SemuBot/SemuBot-PCB/SemuBot_WheelBase/README.md

# Wheelbase

## Components

### BLDC driver

https://www.mouser.ee/ProductDetail/Texas-Instruments/DRV8353FSRTAR?qs=hd1VzrDQEGj9xu7LrY%252BpOw%3D%3D

#### Mosfets

 DI025N06PT-AQ 
 https://www.mouser.ee/ProductDetail/Diotec-Semiconductor/DI025N06PT-AQ?qs=Y0Uzf4wQF3lNF%252Ba3rVyVBQ%3D%3D

#### Oscillator

830205889709
https://www.mouser.ee/ProductDetail/Wurth-Elektronik/830205889709?qs=hWgE7mdIu5QkPZnGbsg1Rg%3D%3D

#### Terminal block connector for 24V from battery

 TB003-500-P02BE

https://www.mouser.ee/ProductDetail/Same-Sky/TB003-500-P02BE?qs=vLWxofP3U2yAT9CFQJ%2FCaw%3D%3D

### USB C connector

https://www.mouser.ee/ProductDetail/Amphenol-FCI/10155435-00011LF?qs=vHuUswq2%252BswoQuNbiiIX%2FQ%3D%3D

### LDO Voltage Regulator
https://www.mouser.ee/ProductDetail/onsemi/NCP164CSN330T1G?qs=xZ%2FP%252Ba9zWqbi%2FAyy5UtoRw%3D%3D

### B5B-XH-A(LF)(SN) HALL Sensor connectors

https://www.mouser.ee/ProductDetail/JST-Commercial/B5B-XH-ALFSN?qs=cdbOS8ANM9ApoXpxtybURg%3D%3D

### ESD Protection

PRTR5V0U2X,215

https://www.mouser.ee/ProductDetail/Nexperia/PRTR5V0U2X215?qs=LOCUfHb8d9sDkgY4cRj8Lw%3D%3D

### Phase connectors for motors

1984620

https://www.snapeda.com/parts/1984620/Phoenix%20Contact/view-part/?ref=search&t=1984620

### Power connector XT30PW-M

https://www.tme.eu/ee/details/xt30pw-m/dc-uhendused/amass/ # 24V
https://www.tme.eu/ee/details/mr30pw-m/dc-uhendused/amass/ # motor

## Pins

* SPI pins for data
* 3x2xGPIO pin for drivers
* 3xPWM for drivers

Hc = Blue
HB = White
Ha = Yellow

Mc = Brown thick
Mb = Green thick
Ma = Orange thick

TOTAL NEEDED FROM STM32: 9(drivers)+ 3CS + SPI =13

### Encoders

* +5V
* DATA
* CLOCK
* GND
* CS
