SemuBot/SemuBot-PCB/(list of files, drawings)

Other design files:
SemuBot_WheelBase/hw_version/Wheelbase/freerouting.dsn
