SemuBot/SemuBot-PCB/SemuBot_WheelBase/Wheelbase/Wheelbase.kicad_pcb

## KiCad design SemuBot_WheelBase/Wheelbase/Wheelbase.kicad_pcb (2025-12-12)

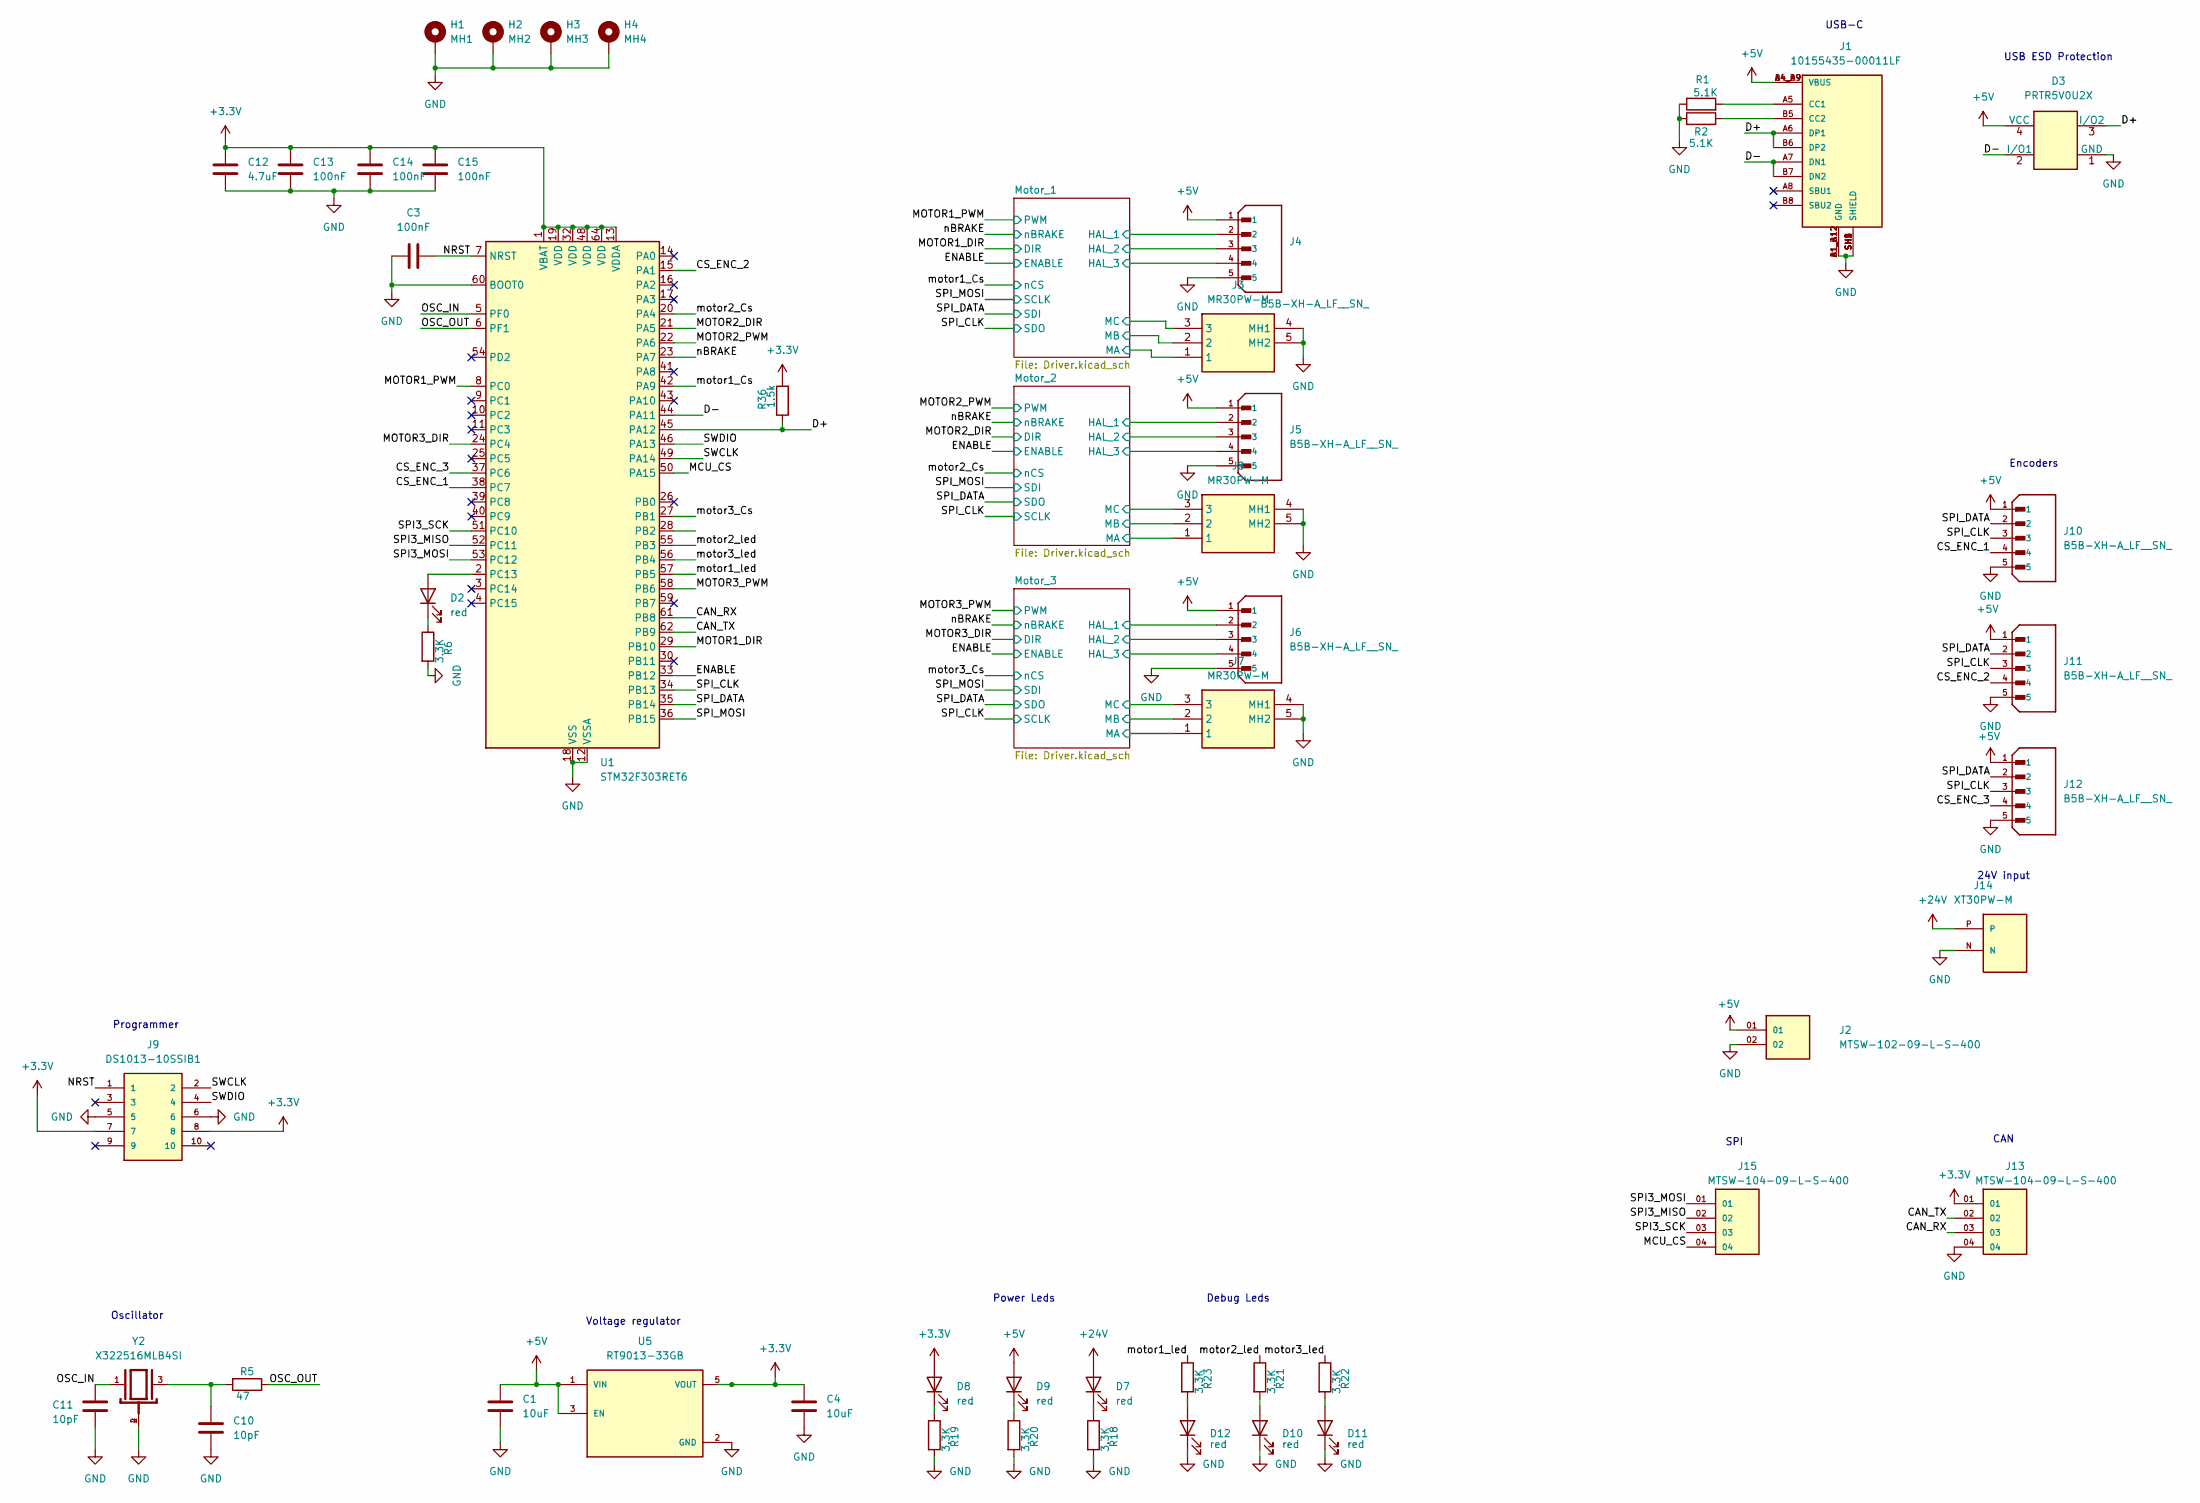
[picture p1: schematic Wheelbase.kicad_sch]

Parts:
C1, C4: 10uF; C_0805_2012Metric_Pad1.18x1.45mm_HandSolder
C3, C13, C14, C15: 100nF; C_0603_1608Metric_Pad1.08x0.95mm_HandSolder
C10, C11: 10pF; C_0603_1608Metric_Pad1.08x0.95mm_HandSolder
C12: 4.7uF; C_0603_1608Metric_Pad1.08x0.95mm_HandSolder
D2, D7, D8, D9, D10, D11, D12: red; LED_0603_1608Metric_Pad1.05x0.95mm_HandSolder
D3: PRTR5V0U2X; SOT-143
H1: MH1; MountingHole_3.2mm_M3_Pad_Via
H2: MH2; MountingHole_3.2mm_M3_Pad_Via
H3: MH3; MountingHole_3.2mm_M3_Pad_Via
H4: MH4; MountingHole_3.2mm_M3_Pad_Via
J1: 10155435-00011LF; AMPHENOL_10155435-00011LF; PARTREV C
J2: MTSW-102-09-L-S-400; SAMTEC_MTSW-102-09-L-S-400; PARTREV R
J3, J7, J8: MR30PW-M; MR30PWM; Manufacturer_Part_Number MR30PW-M
J4, J5, J6, J10, J11, J12: B5B-XH-A_LF__SN_; JST_B5B-XH-A_LF__SN_; PARTREV 7/4/21
J9: DS1013-10SSIB1; CONNFLY_DS1013-10SSIB1; PARTREV G
J13, J15: MTSW-104-09-L-S-400; SAMTEC_MTSW-104-09-L-S-400; PARTREV R
J14: XT30PW-M; AMASS_XT30PW-M; PARTREV 1.2
R1, R2: 5.1K; R_0603_1608Metric_Pad0.98x0.95mm_HandSolder
R5: 47; R_0603_1608Metric_Pad0.98x0.95mm_HandSolder
R6, R18, R19, R20, R21, R22, R23: 3.3K; R_0603_1608Metric_Pad0.98x0.95mm_HandSolder
R36: 1.5k; R_0603_1608Metric_Pad0.98x0.95mm_HandSolder
U1: STM32F303RET6; LQFP-64_10x10mm_P0.5mm
U5: RT9013-33GB; SOT94P279X129-5N; PARTREV Aprill 2011
Y2: X322516MLB4SI; OSC_X322516MLB4SI; PARTREV N/A

Connections:
+3.3V: C4.2, C12.1, C13.1, C14.1, C15.1, D8.2 (A), J9.7, J9.8, J13.01, R36.2, U1.1 (VBAT), U1.13 (VDDA), U1.19 (VDD), U1.32 (VDD), U1.48 (VDD), U1.64 (VDD), U5.5 (VOUT)
+5V: C1.2, D3.4 (VCC), D9.2 (A), J1.A4_B9 (VBUS), J1.B4_A9 (VBUS), J2.01, J4.1, J5.1, J6.1, J10.1, J11.1, J12.1, U5.1 (VIN), U5.3 (EN); also elsewhere on the board
+24V: D7.2 (A), J14.P; also elsewhere on the board
/CAN_RX: J13.03, U1.61 (PB8)
/CAN_TX: J13.02, U1.62 (PB9)
/CS_ENC_1: J10.4, U1.38 (PC7)
/CS_ENC_2: J11.4, U1.15 (PA1)
/CS_ENC_3: J12.4, U1.37 (PC6)
/D+: D3.3 (I/O2), J1.A6 (DP1), J1.B6 (DP2), R36.1, U1.45 (PA12)
/D-: D3.2 (I/O1), J1.A7 (DN1), J1.B7 (DN2), U1.44 (PA11)
/ENABLE: U1.33 (PB12); also elsewhere on the board
/MCU_CS: J15.04, U1.50 (PA15)
/MOTOR1_DIR: U1.29 (PB10); also elsewhere on the board
/MOTOR1_PWM: U1.8 (PC0); also elsewhere on the board
/MOTOR2_DIR: U1.21 (PA5); also elsewhere on the board
/MOTOR2_PWM: U1.22 (PA6); also elsewhere on the board
/MOTOR3_DIR: U1.24 (PC4); also elsewhere on the board
/MOTOR3_PWM: U1.58 (PB6); also elsewhere on the board
/Motor_1/HAL_1: J4.2; also elsewhere on the board
/Motor_1/HAL_2: J4.3; also elsewhere on the board
/Motor_1/HAL_3: J4.4; also elsewhere on the board
/Motor_1/SHA: J3.1; also elsewhere on the board
/Motor_1/SHB: J3.2; also elsewhere on the board
/Motor_1/SHC: J3.3; also elsewhere on the board
/Motor_2/HAL_1: J5.2; also elsewhere on the board
/Motor_2/HAL_2: J5.3; also elsewhere on the board
/Motor_2/HAL_3: J5.4; also elsewhere on the board
/Motor_2/SHA: J8.1; also elsewhere on the board
/Motor_2/SHB: J8.2; also elsewhere on the board
/Motor_2/SHC: J8.3; also elsewhere on the board
/Motor_3/HAL_1: J6.2; also elsewhere on the board
/Motor_3/HAL_2: J6.3; also elsewhere on the board
/Motor_3/HAL_3: J6.4; also elsewhere on the board
/Motor_3/SHA: J7.1; also elsewhere on the board
/Motor_3/SHB: J7.2; also elsewhere on the board
/Motor_3/SHC: J7.3; also elsewhere on the board
/NRST: C3.2, J9.1, U1.7 (NRST)
/OSC_IN: C11.1, U1.5 (PF0), Y2.1
/OSC_OUT: R5.1, U1.6 (PF1)
/SPI3_MISO: J15.02, U1.52 (PC11)
/SPI3_MOSI: J15.01, U1.53 (PC12)
/SPI3_SCK: J15.03, U1.51 (PC10)
/SPI_MOSI: U1.36 (PB15); also elsewhere on the board
/SWCLK: J9.2, U1.49 (PA14)
/SWDIO: J9.4, U1.46 (PA13)
/motor1_Cs: U1.42 (PA9); also elsewhere on the board
/motor1_led: R23.1, U1.57 (PB5)
/motor2_Cs: U1.20 (PA4); also elsewhere on the board
/motor2_led: R21.1, U1.55 (PB3)
/motor3_Cs: U1.27 (PB1); also elsewhere on the board
/motor3_led: R22.1, U1.56 (PB4)
/nBRAKE: U1.23 (PA7); also elsewhere on the board
GND: C1.1, C3.1, C4.1, C10.1, C11.2, C12.2, C13.2, C14.2, C15.2, D3.1 (GND), D10.1 (K), D11.1 (K), D12.1 (K), H1.1, H2.1, H3.1, H4.1, J1.A1_B12 (GND), J1.B1_A12 (GND), J1.SH1 (SHIELD), J1.SH2 (SHIELD), J1.SH3 (SHIELD), J1.SH4 (SHIELD), J2.02, J3.4 (MH1), J3.5 (MH2), J4.5, J5.5, J6.5, J7.4 (MH1), J7.5 (MH2), J8.4 (MH1), J8.5 (MH2), J9.5, J9.6, J10.5, J11.5, J12.5, J13.04, J14.N, R1.1, R2.1, R6.2, R18.2, R19.2, R20.2, U1.12 (VSSA), U1.18 (VSS), U1.31 (VSS), U1.47 (VSS), U1.60 (BOOT0), U1.63 (VSS), U5.2 (GND), Y2.2, Y2.4; also elsewhere on the board
unnamed: C10.2, R5.2, Y2.3
unnamed: D2.2 (A), U1.2 (PC13)
unnamed: D2.1 (K), R6.1
unnamed: D7.1 (K), R18.1
unnamed: D8.1 (K), R19.1
unnamed: D9.1 (K), R20.1
unnamed: D10.2 (A), R21.2
unnamed: D11.2 (A), R22.2
unnamed: D12.2 (A), R23.2
unnamed: J1.A5 (CC1), R1.2
unnamed: J1.B5 (CC2), R2.2

Notes on the sheet:
24V input
Encoders
SPI
Debug Leds
Oscillator
USB-C
USB ESD Protection
CAN
Power Leds
Programmer
Voltage regulator

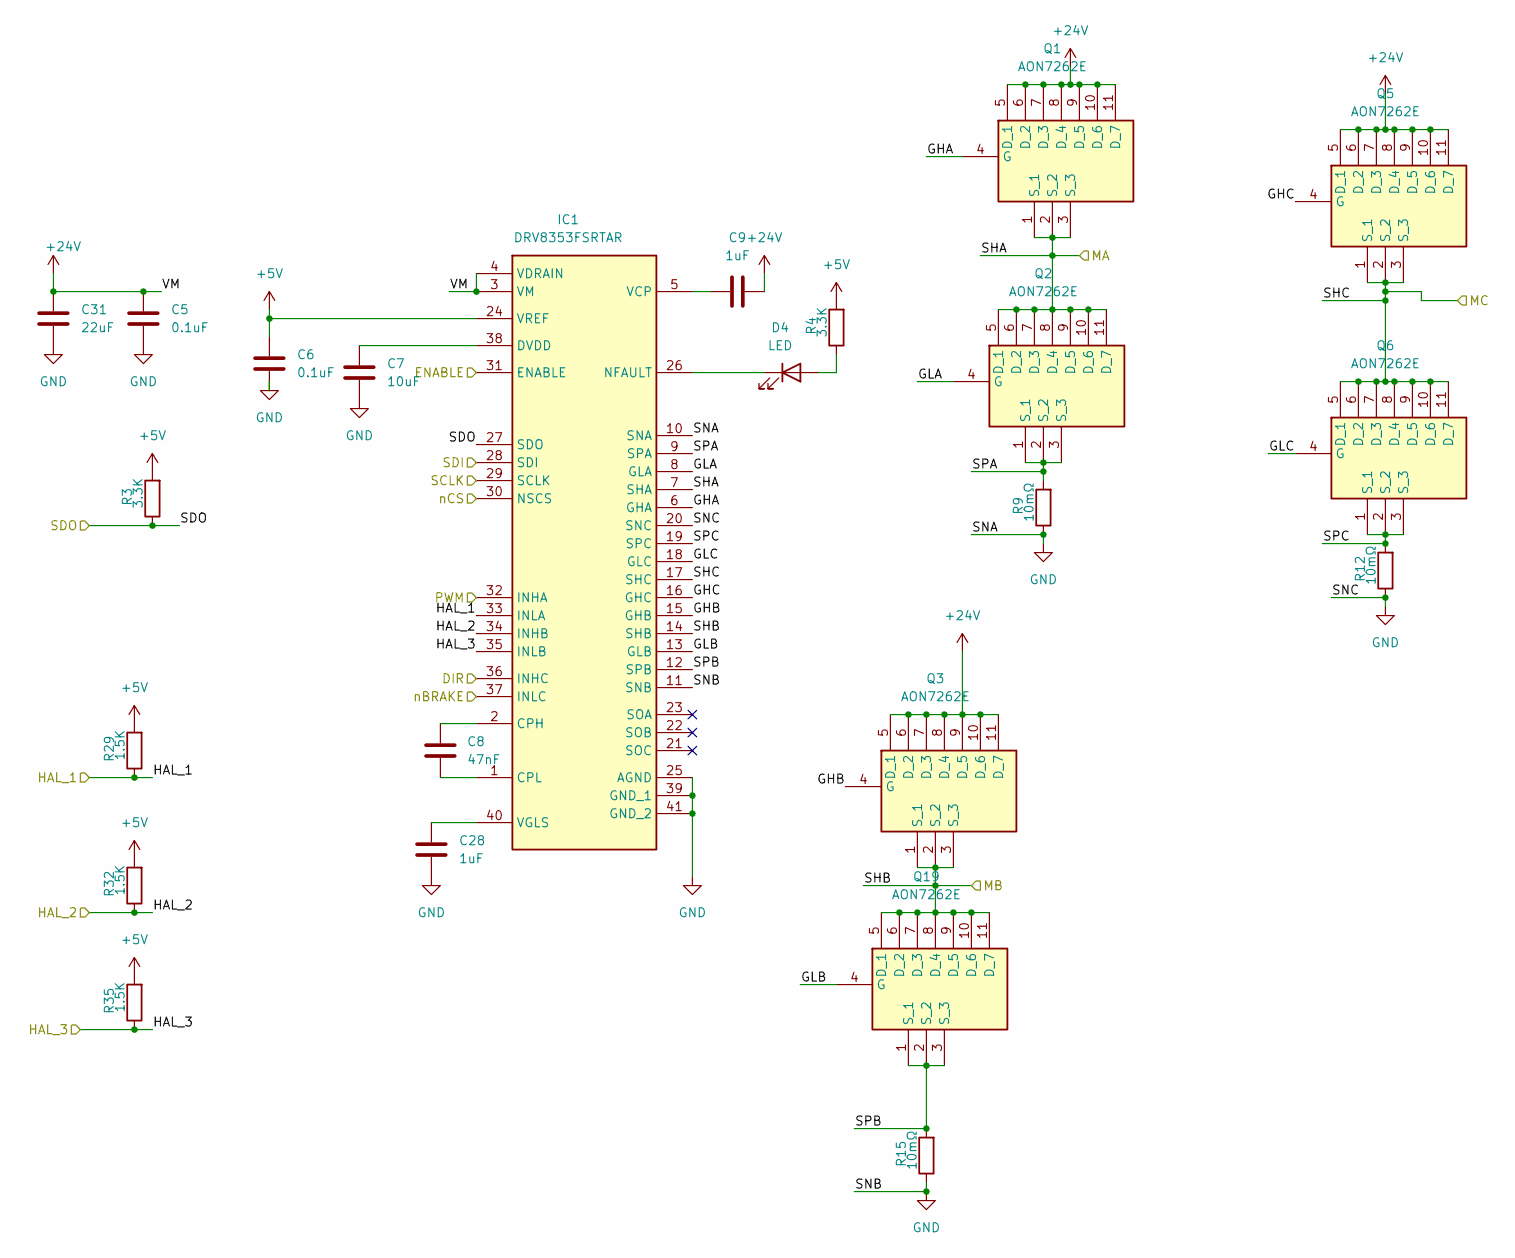
[picture p2: schematic Driver.kicad_sch]

Parts:
C5, C6: 0.1uF; C_0603_1608Metric_Pad1.08x0.95mm_HandSolder
C7: 10uF; C_0603_1608Metric_Pad1.08x0.95mm_HandSolder
C8: 47nF; C_0603_1608Metric_Pad1.08x0.95mm_HandSolder
C9, C28: 1uF; C_0603_1608Metric_Pad1.08x0.95mm_HandSolder
C31: 22uF; C_0805_2012Metric_Pad1.18x1.45mm_HandSolder
D4: LED; LED_0603_1608Metric_Pad1.05x0.95mm_HandSolder
IC1: DRV8353FSRTAR; QFN50P600X600X80-41N-D; Mouser Part Number 595-DRV8353FSRTAR
Q1, Q2, Q3, Q5, Q6, Q19: AON7262E; Manufacturer_Part_Number AON7262E
R3, R4: 3.3K; R_0603_1608Metric_Pad0.98x0.95mm_HandSolder
R9, R12, R15: 10mΩ; R_2512_6332Metric_Pad1.40x3.35mm_HandSolder
R29, R32, R35: 1.5K; R_0603_1608Metric_Pad0.98x0.95mm_HandSolder

Connections:
+5V: C6.1, IC1.24 (VREF), R3.2, R4.2, R29.2, R32.2, R35.2; also elsewhere on the board
+24V: C5.1, C9.2, C31.2, IC1.3 (VM), IC1.4 (VDRAIN), Q1.5 (D_1), Q1.6 (D_2), Q1.7 (D_3), Q1.8 (D_4), Q1.9 (D_5), Q1.10 (D_6), Q1.11 (D_7), Q3.5 (D_1), Q3.6 (D_2), Q3.7 (D_3), Q3.8 (D_4), Q3.9 (D_5), Q3.10 (D_6), Q3.11 (D_7), Q5.5 (D_1), Q5.6 (D_2), Q5.7 (D_3), Q5.8 (D_4), Q5.9 (D_5), Q5.10 (D_6), Q5.11 (D_7); also elsewhere on the board
/ENABLE: IC1.31 (ENABLE); also elsewhere on the board
/MOTOR1_DIR: IC1.36 (INHC); also elsewhere on the board
/MOTOR1_PWM: IC1.32 (INHA); also elsewhere on the board
/Motor_1/GHA: IC1.6 (GHA), Q1.4 (G)
/Motor_1/GHB: IC1.15 (GHB), Q3.4 (G)
/Motor_1/GHC: IC1.16 (GHC), Q5.4 (G)
/Motor_1/GLA: IC1.8 (GLA), Q2.4 (G)
/Motor_1/GLB: IC1.13 (GLB), Q19.4 (G)
/Motor_1/GLC: IC1.18 (GLC), Q6.4 (G)
/Motor_1/HAL_1: IC1.33 (INLA), R29.1; also elsewhere on the board
/Motor_1/HAL_2: IC1.34 (INHB), R32.1; also elsewhere on the board
/Motor_1/HAL_3: IC1.35 (INLB), R35.1; also elsewhere on the board
/Motor_1/SHA: IC1.7 (SHA), Q1.1 (S_1), Q1.2 (S_2), Q1.3 (S_3), Q2.5 (D_1), Q2.6 (D_2), Q2.7 (D_3), Q2.8 (D_4), Q2.9 (D_5), Q2.10 (D_6), Q2.11 (D_7); also elsewhere on the board
/Motor_1/SHB: IC1.14 (SHB), Q3.1 (S_1), Q3.2 (S_2), Q3.3 (S_3), Q19.5 (D_1), Q19.6 (D_2), Q19.7 (D_3), Q19.8 (D_4), Q19.9 (D_5), Q19.10 (D_6), Q19.11 (D_7); also elsewhere on the board
/Motor_1/SHC: IC1.17 (SHC), Q5.1 (S_1), Q5.2 (S_2), Q5.3 (S_3), Q6.5 (D_1), Q6.6 (D_2), Q6.7 (D_3), Q6.8 (D_4), Q6.9 (D_5), Q6.10 (D_6), Q6.11 (D_7); also elsewhere on the board
/Motor_1/SPA: IC1.9 (SPA), Q2.1 (S_1), Q2.2 (S_2), Q2.3 (S_3), R9.2
/Motor_1/SPB: IC1.12 (SPB), Q19.1 (S_1), Q19.2 (S_2), Q19.3 (S_3), R15.2
/Motor_1/SPC: IC1.19 (SPC), Q6.1 (S_1), Q6.2 (S_2), Q6.3 (S_3), R12.2
/SPI_MOSI: IC1.29 (SCLK); also elsewhere on the board
/motor1_Cs: IC1.30 (NSCS); also elsewhere on the board
/nBRAKE: IC1.37 (INLC); also elsewhere on the board
GND: C5.2, C6.2, C7.2, C28.1, C31.1, IC1.10 (SNA), IC1.11 (SNB), IC1.20 (SNC), IC1.25 (AGND), IC1.39 (GND_1), IC1.41 (GND_2), R9.1, R12.1, R15.1; also elsewhere on the board
unnamed: D4.2 (A), R4.1
unnamed: D4.1 (K), IC1.26 (NFAULT)
unnamed: C8.1, IC1.2 (CPH)
unnamed: C8.2, IC1.1 (CPL)
unnamed: C7.1, IC1.38 (DVDD)
unnamed: C9.1, IC1.5 (VCP)
unnamed: C28.2, IC1.40 (VGLS)

Parts of its further copies:
C17, C18, C23, C24: 0.1uF; C_0603_1608Metric_Pad1.08x0.95mm_HandSolder
C19, C25: 10uF; C_0603_1608Metric_Pad1.08x0.95mm_HandSolder
C20, C26: 47nF; C_0603_1608Metric_Pad1.08x0.95mm_HandSolder
C21, C27, C29, C30: 1uF; C_0603_1608Metric_Pad1.08x0.95mm_HandSolder
C32, C33: 22uF; C_0805_2012Metric_Pad1.18x1.45mm_HandSolder
D5, D6: LED; LED_0603_1608Metric_Pad1.05x0.95mm_HandSolder
IC2, IC3: DRV8353FSRTAR; QFN50P600X600X80-41N-D; Mouser Part Number 595-DRV8353FSRTAR
Q4, Q7, Q8, Q9, Q10, Q11, Q12, Q13, Q14, Q15, Q20, Q21: AON7262E; Manufacturer_Part_Number AON7262E
R7, R8, R24, R25: 3.3K; R_0603_1608Metric_Pad0.98x0.95mm_HandSolder
R10, R11, R13, R14, R16, R17: 10mΩ; R_2512_6332Metric_Pad1.40x3.35mm_HandSolder
R30, R31, R33, R34, R37, R38: 1.5K; R_0603_1608Metric_Pad0.98x0.95mm_HandSolder

Connections of its further copies:
+5V: C18.1, C24.1, IC2.24 (VREF), IC3.24 (VREF), R7.2, R8.2, R24.2, R25.2, R30.2, R31.2, R33.2, R34.2, R37.2, R38.2; also elsewhere on the board
+24V: C17.1, C21.2, C23.1, C27.2, C32.2, C33.2, IC2.3 (VM), IC2.4 (VDRAIN), IC3.3 (VM), IC3.4 (VDRAIN), Q4.5 (D_1), Q4.6 (D_2), Q4.7 (D_3), Q4.8 (D_4), Q4.9 (D_5), Q4.10 (D_6), Q4.11 (D_7), Q7.5 (D_1), Q7.6 (D_2), Q7.7 (D_3), Q7.8 (D_4), Q7.9 (D_5), Q7.10 (D_6), Q7.11 (D_7), Q9.5 (D_1), Q9.6 (D_2), Q9.7 (D_3), Q9.8 (D_4), Q9.9 (D_5), Q9.10 (D_6), Q9.11 (D_7), Q11.5 (D_1), Q11.6 (D_2), Q11.7 (D_3), Q11.8 (D_4), Q11.9 (D_5), Q11.10 (D_6), Q11.11 (D_7), Q13.5 (D_1), Q13.6 (D_2), Q13.7 (D_3), Q13.8 (D_4), Q13.9 (D_5), Q13.10 (D_6), Q13.11 (D_7), Q15.5 (D_1), Q15.6 (D_2), Q15.7 (D_3), Q15.8 (D_4), Q15.9 (D_5), Q15.10 (D_6), Q15.11 (D_7); also elsewhere on the board
/ENABLE: IC2.31 (ENABLE), IC3.31 (ENABLE); also elsewhere on the board
/MOTOR2_DIR: IC2.36 (INHC); also elsewhere on the board
/MOTOR2_PWM: IC2.32 (INHA); also elsewhere on the board
/MOTOR3_DIR: IC3.36 (INHC); also elsewhere on the board
/MOTOR3_PWM: IC3.32 (INHA); also elsewhere on the board
/Motor_2/GHA: IC2.6 (GHA), Q7.4 (G)
/Motor_2/GHB: IC2.15 (GHB), Q4.4 (G)
/Motor_2/GHC: IC2.16 (GHC), Q11.4 (G)
/Motor_2/GLA: IC2.8 (GLA), Q8.4 (G)
/Motor_2/GLB: IC2.13 (GLB), Q20.4 (G)
/Motor_2/GLC: IC2.18 (GLC), Q10.4 (G)
/Motor_2/HAL_1: IC2.33 (INLA), R30.1; also elsewhere on the board
/Motor_2/HAL_2: IC2.34 (INHB), R33.1; also elsewhere on the board
/Motor_2/HAL_3: IC2.35 (INLB), R37.1; also elsewhere on the board
/Motor_2/SHA: IC2.7 (SHA), Q7.1 (S_1), Q7.2 (S_2), Q7.3 (S_3), Q8.5 (D_1), Q8.6 (D_2), Q8.7 (D_3), Q8.8 (D_4), Q8.9 (D_5), Q8.10 (D_6), Q8.11 (D_7); also elsewhere on the board
/Motor_2/SHB: IC2.14 (SHB), Q4.1 (S_1), Q4.2 (S_2), Q4.3 (S_3), Q20.5 (D_1), Q20.6 (D_2), Q20.7 (D_3), Q20.8 (D_4), Q20.9 (D_5), Q20.10 (D_6), Q20.11 (D_7); also elsewhere on the board
/Motor_2/SHC: IC2.17 (SHC), Q10.5 (D_1), Q10.6 (D_2), Q10.7 (D_3), Q10.8 (D_4), Q10.9 (D_5), Q10.10 (D_6), Q10.11 (D_7), Q11.1 (S_1), Q11.2 (S_2), Q11.3 (S_3); also elsewhere on the board
/Motor_2/SPA: IC2.9 (SPA), Q8.1 (S_1), Q8.2 (S_2), Q8.3 (S_3), R10.2
/Motor_2/SPB: IC2.12 (SPB), Q20.1 (S_1), Q20.2 (S_2), Q20.3 (S_3), R16.2
/Motor_2/SPC: IC2.19 (SPC), Q10.1 (S_1), Q10.2 (S_2), Q10.3 (S_3), R13.2
/Motor_3/GHA: IC3.6 (GHA), Q13.4 (G)
/Motor_3/GHB: IC3.15 (GHB), Q9.4 (G)
/Motor_3/GHC: IC3.16 (GHC), Q15.4 (G)
/Motor_3/GLA: IC3.8 (GLA), Q14.4 (G)
/Motor_3/GLB: IC3.13 (GLB), Q21.4 (G)
/Motor_3/GLC: IC3.18 (GLC), Q12.4 (G)
/Motor_3/HAL_1: IC3.33 (INLA), R31.1; also elsewhere on the board
/Motor_3/HAL_2: IC3.34 (INHB), R34.1; also elsewhere on the board
/Motor_3/HAL_3: IC3.35 (INLB), R38.1; also elsewhere on the board
/Motor_3/SHA: IC3.7 (SHA), Q13.1 (S_1), Q13.2 (S_2), Q13.3 (S_3), Q14.5 (D_1), Q14.6 (D_2), Q14.7 (D_3), Q14.8 (D_4), Q14.9 (D_5), Q14.10 (D_6), Q14.11 (D_7); also elsewhere on the board
/Motor_3/SHB: IC3.14 (SHB), Q9.1 (S_1), Q9.2 (S_2), Q9.3 (S_3), Q21.5 (D_1), Q21.6 (D_2), Q21.7 (D_3), Q21.8 (D_4), Q21.9 (D_5), Q21.10 (D_6), Q21.11 (D_7); also elsewhere on the board
/Motor_3/SHC: IC3.17 (SHC), Q12.5 (D_1), Q12.6 (D_2), Q12.7 (D_3), Q12.8 (D_4), Q12.9 (D_5), Q12.10 (D_6), Q12.11 (D_7), Q15.1 (S_1), Q15.2 (S_2), Q15.3 (S_3); also elsewhere on the board
/Motor_3/SPA: IC3.9 (SPA), Q14.1 (S_1), Q14.2 (S_2), Q14.3 (S_3), R11.2
/Motor_3/SPB: IC3.12 (SPB), Q21.1 (S_1), Q21.2 (S_2), Q21.3 (S_3), R17.2
/Motor_3/SPC: IC3.19 (SPC), Q12.1 (S_1), Q12.2 (S_2), Q12.3 (S_3), R14.2
/SPI_MOSI: IC2.28 (SDI), IC3.28 (SDI); also elsewhere on the board
/motor2_Cs: IC2.30 (NSCS); also elsewhere on the board
/motor3_Cs: IC3.30 (NSCS); also elsewhere on the board
/nBRAKE: IC2.37 (INLC), IC3.37 (INLC); also elsewhere on the board
GND: C17.2, C18.2, C19.2, C23.2, C24.2, C25.2, C29.1, C30.1, C32.1, C33.1, IC2.10 (SNA), IC2.11 (SNB), IC2.20 (SNC), IC2.25 (AGND), IC2.39 (GND_1), IC2.41 (GND_2), IC3.10 (SNA), IC3.11 (SNB), IC3.20 (SNC), IC3.25 (AGND), IC3.39 (GND_1), IC3.41 (GND_2), R10.1, R11.1, R13.1, R14.1, R16.1, R17.1; also elsewhere on the board
unnamed: D5.2 (A), R7.1
unnamed: D5.1 (K), IC2.26 (NFAULT)
unnamed: D6.2 (A), R8.1
unnamed: D6.1 (K), IC3.26 (NFAULT)
unnamed: C20.1, IC2.2 (CPH)
unnamed: C20.2, IC2.1 (CPL)
unnamed: C19.1, IC2.38 (DVDD)
unnamed: C21.1, IC2.5 (VCP)
unnamed: C29.2, IC2.40 (VGLS)
unnamed: C26.1, IC3.2 (CPH)
unnamed: C26.2, IC3.1 (CPL)
unnamed: C25.1, IC3.38 (DVDD)
unnamed: C27.1, IC3.5 (VCP)
unnamed: C30.2, IC3.40 (VGLS)

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
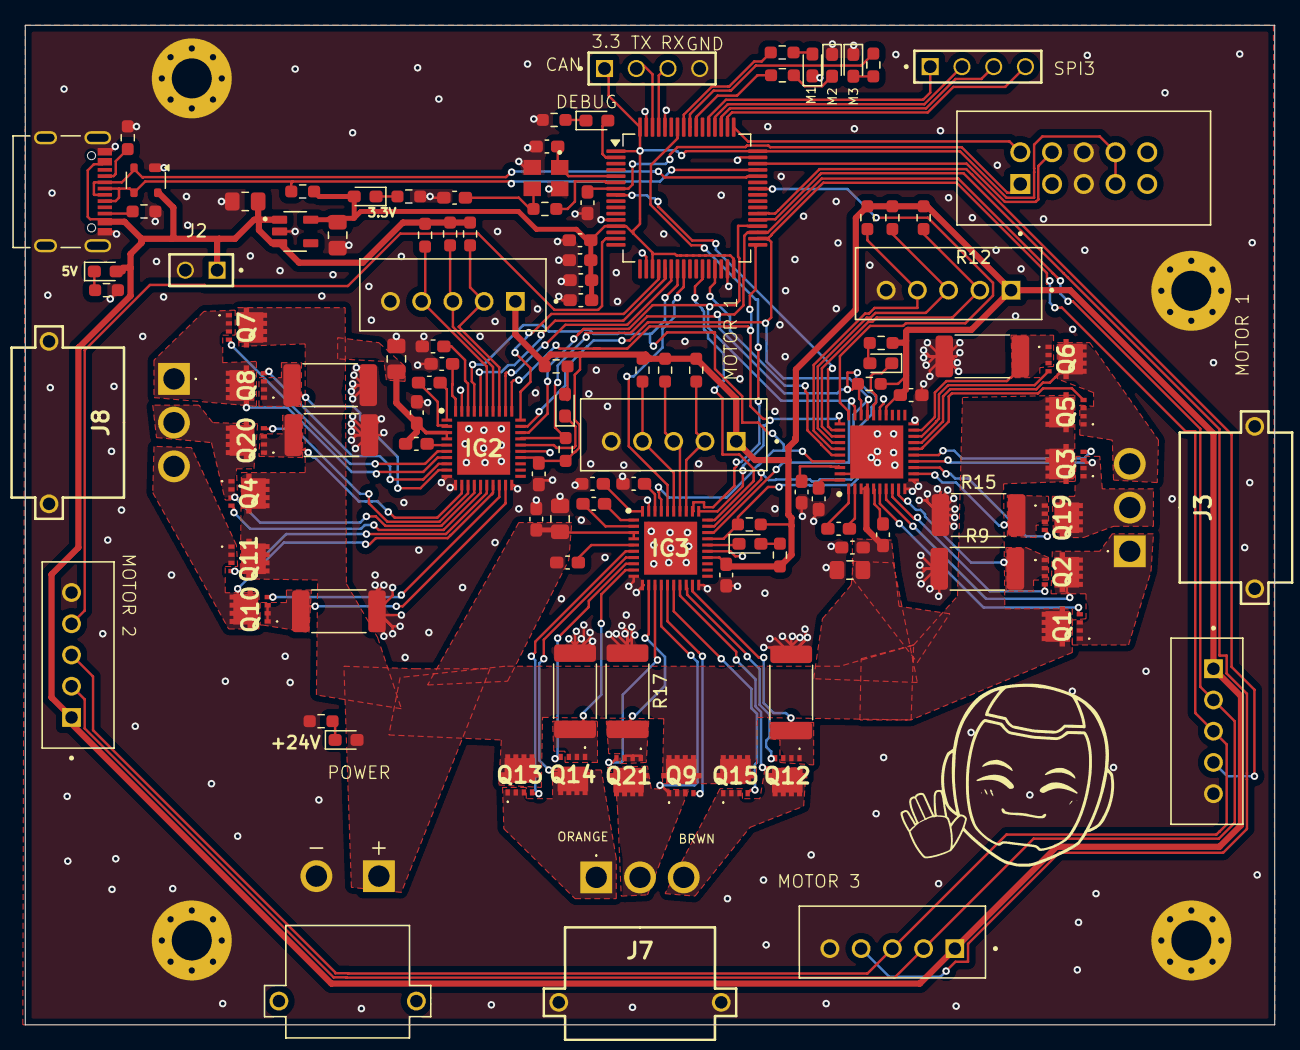
[picture p3: board SemuBot_WheelBase/Wheelbase/Wheelbase.kicad_pcb from above]

Board: 2 copper layers, 100.0 x 80.0 mm, 119 parts (0 on the bottom side), 114 nets.
