SemuBot/SemuBot-PCB/SemuBot_WheelBase/hw_version/Wheelbase/Wheelbase.kicad_pcb

## KiCad design SemuBot_WheelBase/hw_version/Wheelbase/Wheelbase.kicad_pcb (2025-11-24)

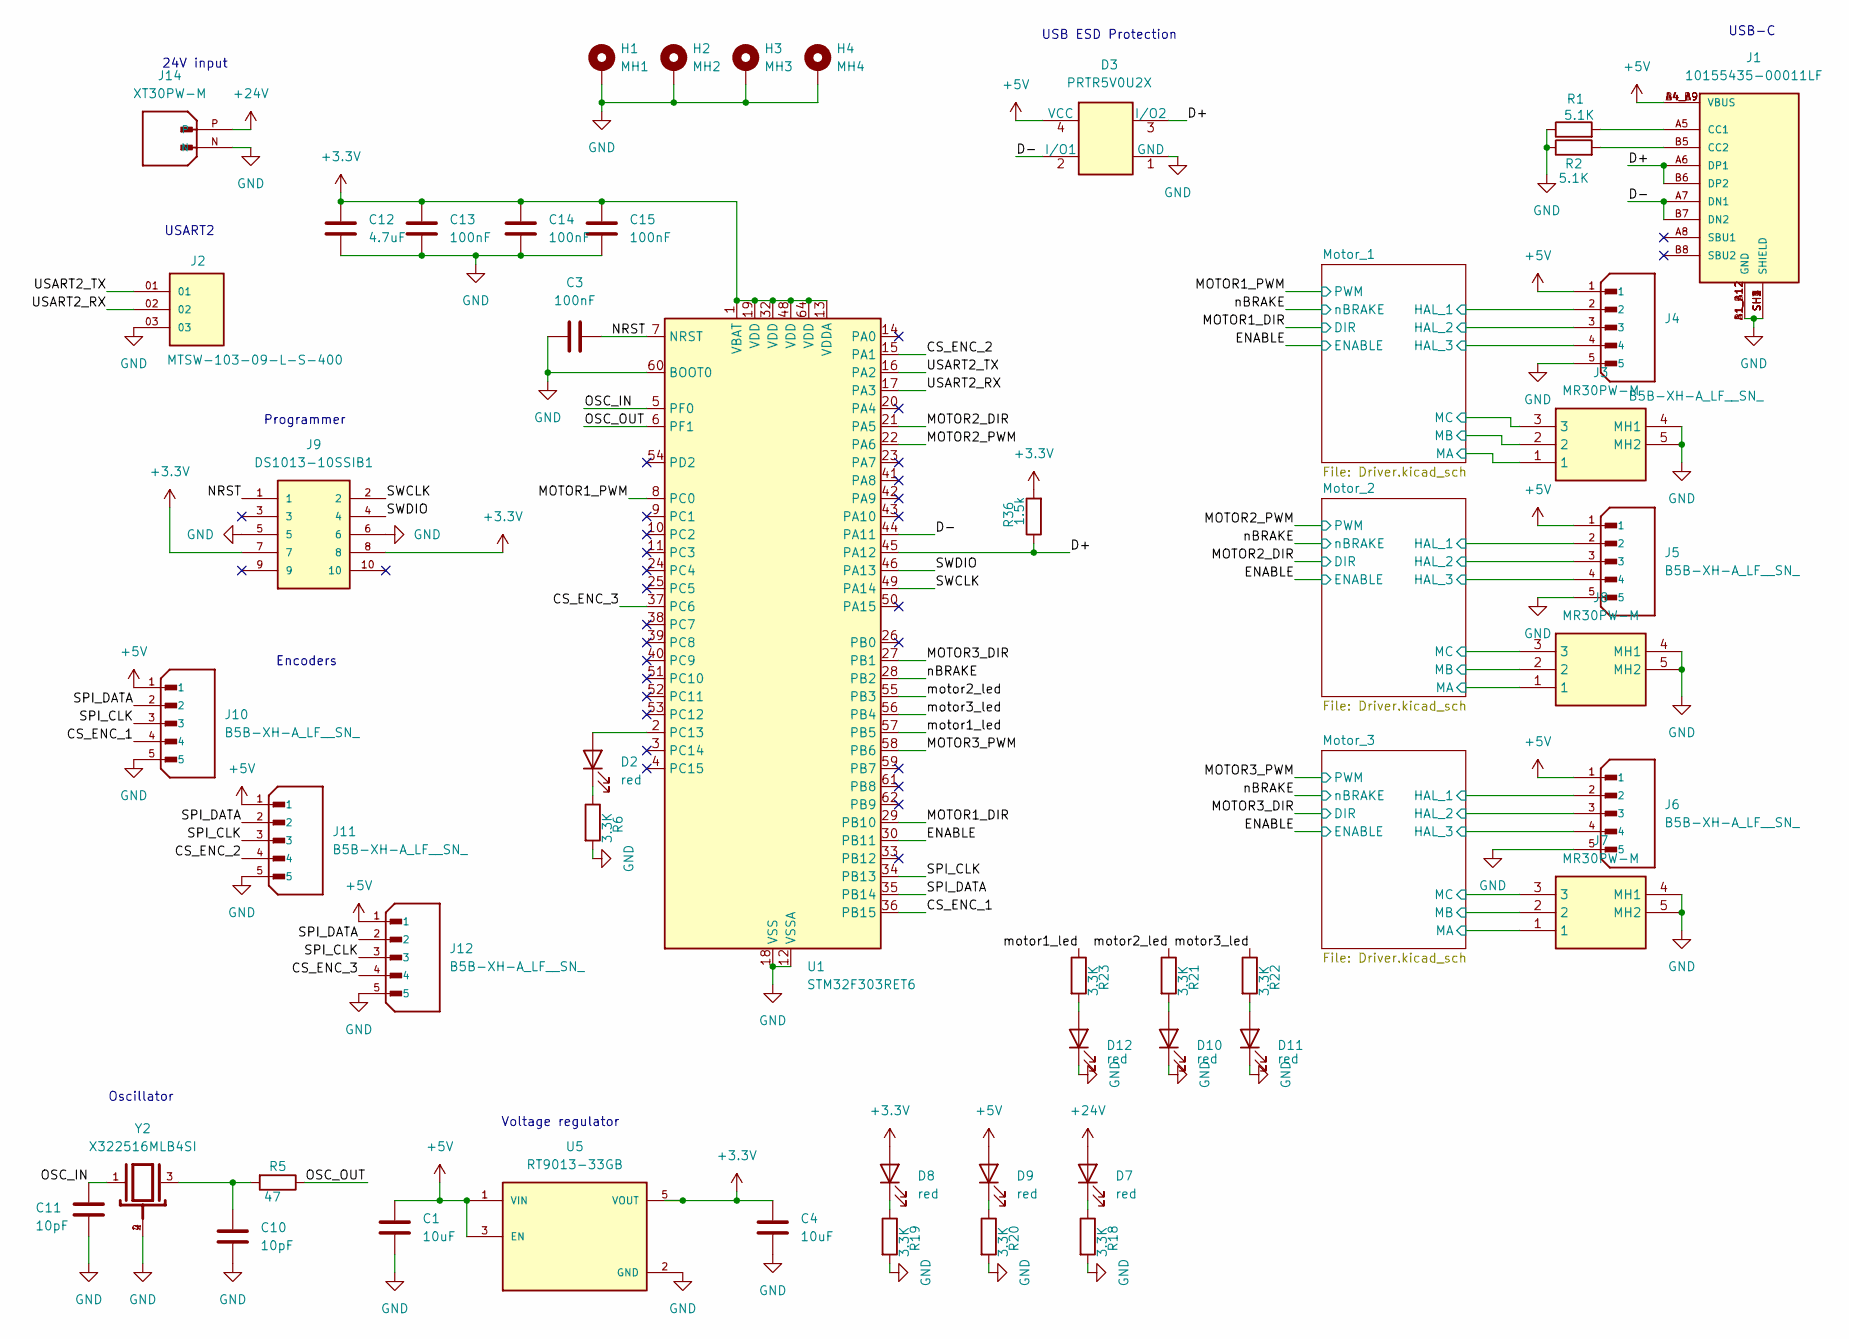
[picture p4: schematic Wheelbase.kicad_sch]

Parts:
C1, C4: 10uF; C_0805_2012Metric_Pad1.18x1.45mm_HandSolder
C3, C13, C14, C15: 100nF; C_0603_1608Metric_Pad1.08x0.95mm_HandSolder
C10, C11: 10pF; C_0603_1608Metric_Pad1.08x0.95mm_HandSolder
C12: 4.7uF; C_0603_1608Metric_Pad1.08x0.95mm_HandSolder
D2, D7, D8, D9, D10, D11, D12: red; LED_0603_1608Metric_Pad1.05x0.95mm_HandSolder
D3: PRTR5V0U2X; SOT-143
H1: MH1; MountingHole_2.2mm_M2_Pad_Via
H2: MH2; MountingHole_2.2mm_M2_Pad_Via
H3: MH3; MountingHole_2.2mm_M2_Pad_Via
H4: MH4; MountingHole_2.2mm_M2_Pad_Via
J1: 10155435-00011LF; AMPHENOL_10155435-00011LF; PARTREV C
J2: MTSW-103-09-L-S-400; SAMTEC_MTSW-103-09-L-S-400; PARTREV R
J3, J7, J8: MR30PW-M; MR30PWM; Manufacturer_Part_Number MR30PW-M
J4, J5, J6, J10, J11, J12: B5B-XH-A_LF__SN_; JST_B5B-XH-A_LF__SN_; PARTREV 7/4/21
J9: DS1013-10SSIB1; CONNFLY_DS1013-10SSIB1; PARTREV G
J14: XT30PW-M; AMASS_XT30PW-M; PARTREV 1.2
R1, R2: 5.1K; R_0603_1608Metric_Pad0.98x0.95mm_HandSolder
R5: 47; R_0603_1608Metric_Pad0.98x0.95mm_HandSolder
R6, R18, R19, R20, R21, R22, R23: 3.3K; R_0603_1608Metric_Pad0.98x0.95mm_HandSolder
R36: 1.5k; R_0603_1608Metric_Pad0.98x0.95mm_HandSolder
U1: STM32F303RET6; LQFP-64_10x10mm_P0.5mm
U5: RT9013-33GB; SOT94P279X129-5N; PARTREV Aprill 2011
Y2: X322516MLB4SI; OSC_X322516MLB4SI; PARTREV N/A

Connections:
+3.3V: C4.2, C12.1, C13.1, C14.1, C15.1, D8.2 (A), J9.7, J9.8, R36.2, U1.1 (VBAT), U1.13 (VDDA), U1.19 (VDD), U1.32 (VDD), U1.48 (VDD), U1.64 (VDD), U5.5 (VOUT)
+5V: C1.2, D3.4 (VCC), D9.2 (A), J1.A4_B9 (VBUS), J1.B4_A9 (VBUS), J4.1, J5.1, J6.1, J10.1, J11.1, J12.1, U5.1 (VIN), U5.3 (EN); also elsewhere on the board
+24V: D7.2 (A), J14.P; also elsewhere on the board
/CS_ENC_1: J10.4, U1.36 (PB15)
/CS_ENC_2: J11.4, U1.15 (PA1)
/CS_ENC_3: J12.4, U1.37 (PC6)
/D+: D3.3 (I/O2), J1.A6 (DP1), J1.B6 (DP2), R36.1, U1.45 (PA12)
/D-: D3.2 (I/O1), J1.A7 (DN1), J1.B7 (DN2), U1.44 (PA11)
/ENABLE: U1.30 (PB11); also elsewhere on the board
/MOTOR1_DIR: U1.29 (PB10); also elsewhere on the board
/MOTOR1_PWM: U1.8 (PC0); also elsewhere on the board
/MOTOR2_DIR: U1.21 (PA5); also elsewhere on the board
/MOTOR2_PWM: U1.22 (PA6); also elsewhere on the board
/MOTOR3_DIR: U1.27 (PB1); also elsewhere on the board
/MOTOR3_PWM: U1.58 (PB6); also elsewhere on the board
/Motor_1/HAL_1: J4.2; also elsewhere on the board
/Motor_1/HAL_2: J4.3; also elsewhere on the board
/Motor_1/HAL_3: J4.4; also elsewhere on the board
/Motor_1/SHA: J3.1; also elsewhere on the board
/Motor_1/SHB: J3.2; also elsewhere on the board
/Motor_1/SHC: J3.3; also elsewhere on the board
/Motor_2/HAL_1: J5.2; also elsewhere on the board
/Motor_2/HAL_2: J5.3; also elsewhere on the board
/Motor_2/HAL_3: J5.4; also elsewhere on the board
/Motor_2/SHA: J8.1; also elsewhere on the board
/Motor_2/SHB: J8.2; also elsewhere on the board
/Motor_2/SHC: J8.3; also elsewhere on the board
/Motor_3/HAL_1: J6.2; also elsewhere on the board
/Motor_3/HAL_2: J6.3; also elsewhere on the board
/Motor_3/HAL_3: J6.4; also elsewhere on the board
/Motor_3/SHA: J7.1; also elsewhere on the board
/Motor_3/SHB: J7.2; also elsewhere on the board
/Motor_3/SHC: J7.3; also elsewhere on the board
/NRST: C3.2, J9.1, U1.7 (NRST)
/OSC_IN: C11.1, U1.5 (PF0), Y2.1
/OSC_OUT: R5.1, U1.6 (PF1)
/SPI_CLK: J10.3, J11.3, J12.3, U1.34 (PB13)
/SPI_DATA: J10.2, J11.2, J12.2, U1.35 (PB14)
/SWCLK: J9.2, U1.49 (PA14)
/SWDIO: J9.4, U1.46 (PA13)
/USART2_RX: J2.02, U1.17 (PA3)
/USART2_TX: J2.01, U1.16 (PA2)
/motor1_led: R23.1, U1.57 (PB5)
/motor2_led: R21.1, U1.55 (PB3)
/motor3_led: R22.1, U1.56 (PB4)
/nBRAKE: U1.28 (PB2); also elsewhere on the board
GND: C1.1, C3.1, C4.1, C10.1, C11.2, C12.2, C13.2, C14.2, C15.2, D3.1 (GND), D10.1 (K), D11.1 (K), D12.1 (K), H1.1, H2.1, H3.1, H4.1, J1.A1_B12 (GND), J1.B1_A12 (GND), J1.SH1 (SHIELD), J1.SH2 (SHIELD), J1.SH3 (SHIELD), J1.SH4 (SHIELD), J2.03, J3.4 (MH1), J3.5 (MH2), J4.5, J5.5, J6.5, J7.4 (MH1), J7.5 (MH2), J8.4 (MH1), J8.5 (MH2), J9.5, J9.6, J10.5, J11.5, J12.5, J14.N, R1.1, R2.1, R6.2, R18.2, R19.2, R20.2, U1.12 (VSSA), U1.18 (VSS), U1.31 (VSS), U1.47 (VSS), U1.60 (BOOT0), U1.63 (VSS), U5.2 (GND), Y2.2, Y2.4; also elsewhere on the board
unnamed: C10.2, R5.2, Y2.3
unnamed: D2.2 (A), U1.2 (PC13)
unnamed: D2.1 (K), R6.1
unnamed: D7.1 (K), R18.1
unnamed: D8.1 (K), R19.1
unnamed: D9.1 (K), R20.1
unnamed: D10.2 (A), R21.2
unnamed: D11.2 (A), R22.2
unnamed: D12.2 (A), R23.2
unnamed: J1.A5 (CC1), R1.2
unnamed: J1.B5 (CC2), R2.2

Notes on the sheet:
24V input
Encoders
Oscillator
USB-C
USB ESD Protection
USART2
Programmer
Voltage regulator
