SemuBot/SemuBot-PCB/SemuBot_WheelBase/hw_version/Wheelbase/Wheelbase.kicad_pcb

## KiCad design SemuBot_WheelBase/hw_version/Wheelbase/Wheelbase.kicad_pcb (continued)

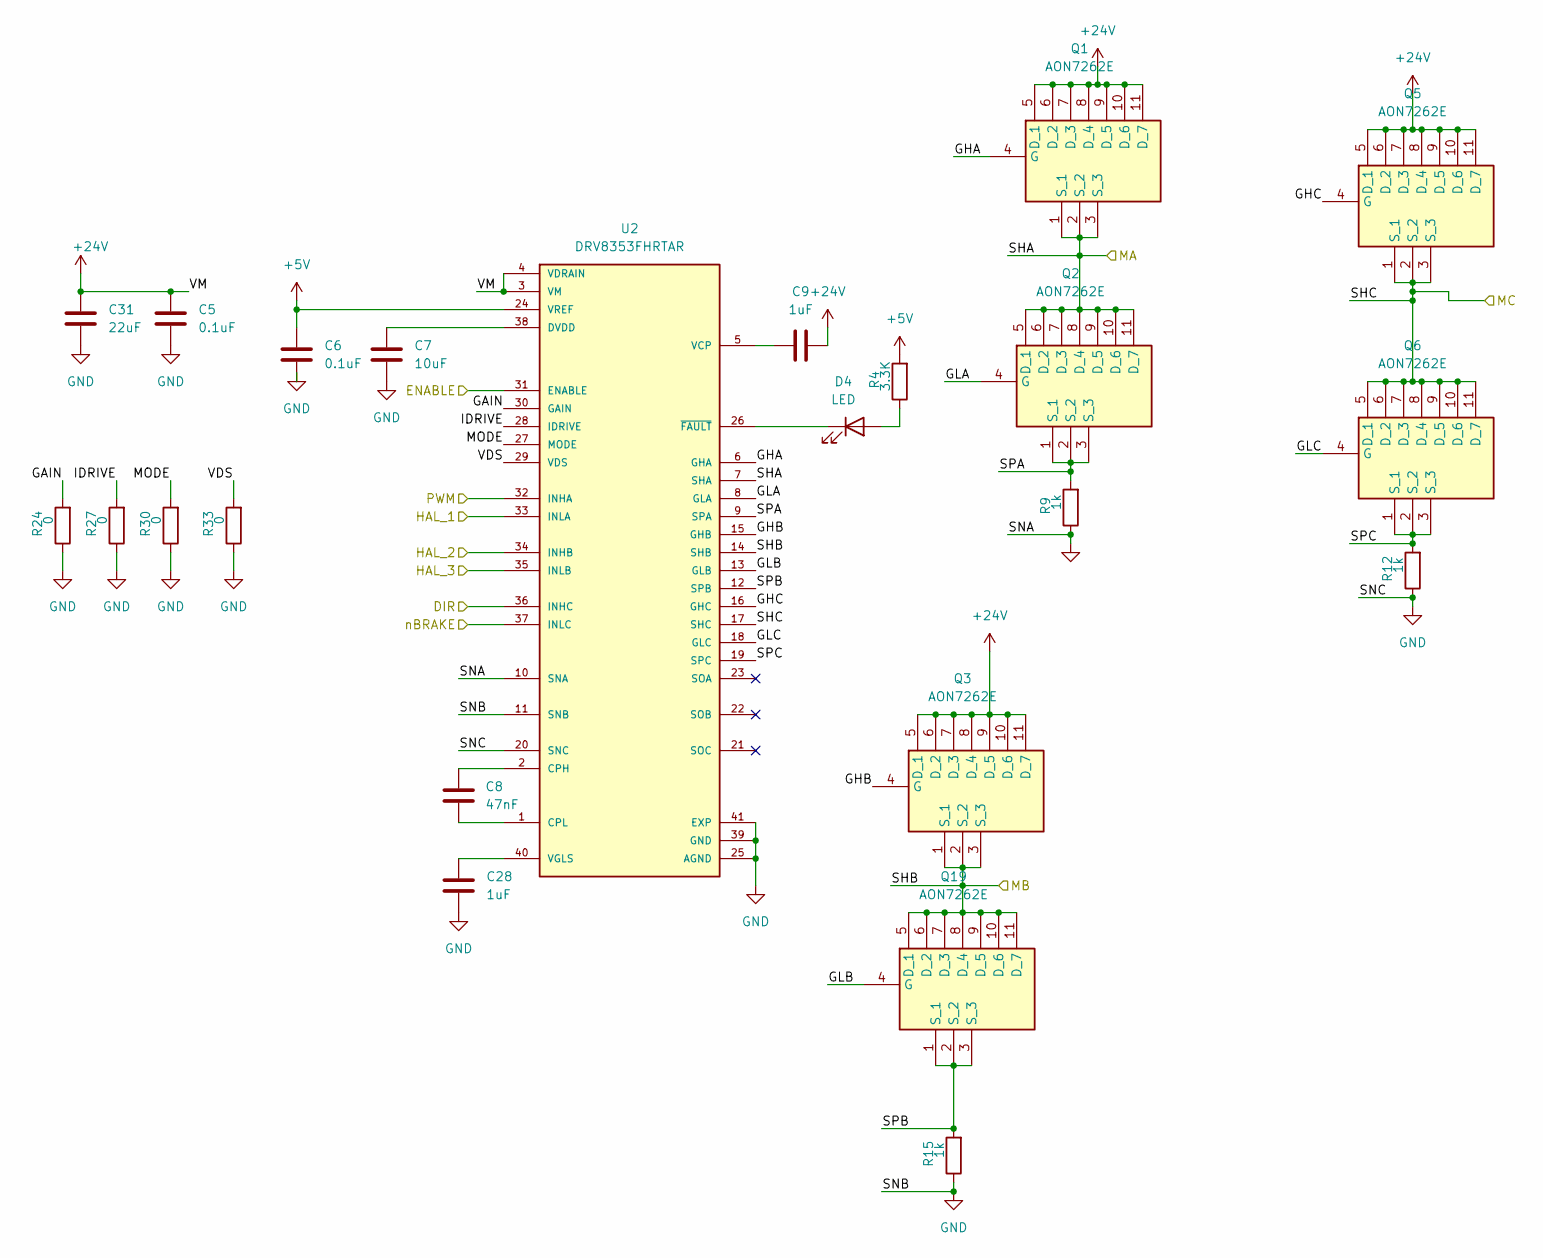
[picture p5: schematic Driver.kicad_sch]

Parts:
C5, C6: 0.1uF; C_0603_1608Metric_Pad1.08x0.95mm_HandSolder
C7: 10uF; C_0603_1608Metric_Pad1.08x0.95mm_HandSolder
C8: 47nF; C_0603_1608Metric_Pad1.08x0.95mm_HandSolder
C9, C28: 1uF; C_0603_1608Metric_Pad1.08x0.95mm_HandSolder
C31: 22uF; C_0805_2012Metric_Pad1.18x1.45mm_HandSolder
D4: LED; LED_0603_1608Metric_Pad1.05x0.95mm_HandSolder
Q1, Q2, Q3, Q5, Q6, Q19: AON7262E; Manufacturer_Part_Number AON7262E
R4: 3.3K; R_0603_1608Metric_Pad0.98x0.95mm_HandSolder
R9, R12, R15: 1k; R_0603_1608Metric_Pad0.98x0.95mm_HandSolder
R24, R27, R30, R33: 0; R_0603_1608Metric_Pad0.98x0.95mm_HandSolder
U2: DRV8353FHRTAR; QFN50P600X600X80-41N; PARTREV A

Connections:
+5V: C6.1, R4.2, U2.24 (VREF); also elsewhere on the board
+24V: C5.1, C9.2, C31.2, Q1.5 (D_1), Q1.6 (D_2), Q1.7 (D_3), Q1.8 (D_4), Q1.9 (D_5), Q1.10 (D_6), Q1.11 (D_7), Q3.5 (D_1), Q3.6 (D_2), Q3.7 (D_3), Q3.8 (D_4), Q3.9 (D_5), Q3.10 (D_6), Q3.11 (D_7), Q5.5 (D_1), Q5.6 (D_2), Q5.7 (D_3), Q5.8 (D_4), Q5.9 (D_5), Q5.10 (D_6), Q5.11 (D_7), U2.3 (VM), U2.4 (VDRAIN); also elsewhere on the board
/ENABLE: U2.31 (ENABLE); also elsewhere on the board
/MOTOR1_DIR: U2.36 (INHC); also elsewhere on the board
/MOTOR1_PWM: U2.32 (INHA); also elsewhere on the board
/Motor_1/GAIN: R24.2, U2.30 (GAIN)
/Motor_1/GHA: Q1.4 (G), U2.6 (GHA)
/Motor_1/GHB: Q3.4 (G), U2.15 (GHB)
/Motor_1/GHC: Q5.4 (G), U2.16 (GHC)
/Motor_1/GLA: Q2.4 (G), U2.8 (GLA)
/Motor_1/GLB: Q19.4 (G), U2.13 (GLB)
/Motor_1/GLC: Q6.4 (G), U2.18 (GLC)
/Motor_1/HAL_1: U2.33 (INLA); also elsewhere on the board
/Motor_1/HAL_2: U2.34 (INHB); also elsewhere on the board
/Motor_1/HAL_3: U2.35 (INLB); also elsewhere on the board
/Motor_1/IDRIVE: R27.2, U2.28 (IDRIVE)
/Motor_1/MODE: R30.2, U2.27 (MODE)
/Motor_1/SHA: Q1.1 (S_1), Q1.2 (S_2), Q1.3 (S_3), Q2.5 (D_1), Q2.6 (D_2), Q2.7 (D_3), Q2.8 (D_4), Q2.9 (D_5), Q2.10 (D_6), Q2.11 (D_7), U2.7 (SHA); also elsewhere on the board
/Motor_1/SHB: Q3.1 (S_1), Q3.2 (S_2), Q3.3 (S_3), Q19.5 (D_1), Q19.6 (D_2), Q19.7 (D_3), Q19.8 (D_4), Q19.9 (D_5), Q19.10 (D_6), Q19.11 (D_7), U2.14 (SHB); also elsewhere on the board
/Motor_1/SHC: Q5.1 (S_1), Q5.2 (S_2), Q5.3 (S_3), Q6.5 (D_1), Q6.6 (D_2), Q6.7 (D_3), Q6.8 (D_4), Q6.9 (D_5), Q6.10 (D_6), Q6.11 (D_7), U2.17 (SHC); also elsewhere on the board
/Motor_1/SPA: Q2.1 (S_1), Q2.2 (S_2), Q2.3 (S_3), R9.2, U2.9 (SPA)
/Motor_1/SPB: Q19.1 (S_1), Q19.2 (S_2), Q19.3 (S_3), R15.2, U2.12 (SPB)
/Motor_1/SPC: Q6.1 (S_1), Q6.2 (S_2), Q6.3 (S_3), R12.2, U2.19 (SPC)
/Motor_1/VDS: R33.2, U2.29 (VDS)
/nBRAKE: U2.37 (INLC); also elsewhere on the board
GND: C5.2, C6.2, C7.2, C28.1, C31.1, R9.1, R12.1, R15.1, R24.1, R27.1, R30.1, R33.1, U2.10 (SNA), U2.11 (SNB), U2.20 (SNC), U2.25 (AGND), U2.39 (GND), U2.41 (EXP); also elsewhere on the board
unnamed: D4.2 (A), R4.1
unnamed: D4.1 (K), U2.26 (~FAULT)
unnamed: C8.1, U2.2 (CPH)
unnamed: C8.2, U2.1 (CPL)
unnamed: C7.1, U2.38 (DVDD)
unnamed: C9.1, U2.5 (VCP)
unnamed: C28.2, U2.40 (VGLS)

Parts of its further copies:
C17, C18, C23, C24: 0.1uF; C_0603_1608Metric_Pad1.08x0.95mm_HandSolder
C19, C25: 10uF; C_0603_1608Metric_Pad1.08x0.95mm_HandSolder
C20, C26: 47nF; C_0603_1608Metric_Pad1.08x0.95mm_HandSolder
C21, C27, C29, C30: 1uF; C_0603_1608Metric_Pad1.08x0.95mm_HandSolder
C32, C33: 22uF; C_0805_2012Metric_Pad1.18x1.45mm_HandSolder
D5, D6: LED; LED_0603_1608Metric_Pad1.05x0.95mm_HandSolder
Q4, Q7, Q8, Q9, Q10, Q11, Q12, Q13, Q14, Q15, Q20, Q21: AON7262E; Manufacturer_Part_Number AON7262E
R7, R8: 3.3K; R_0603_1608Metric_Pad0.98x0.95mm_HandSolder
R10, R11, R13, R14, R16, R17: 1k; R_0603_1608Metric_Pad0.98x0.95mm_HandSolder
R25, R26, R28, R29, R31, R32, R34, R35: 0; R_0603_1608Metric_Pad0.98x0.95mm_HandSolder
U3, U4: DRV8353FHRTAR; QFN50P600X600X80-41N; PARTREV A

Connections of its further copies:
+5V: C18.1, C24.1, R7.2, R8.2, U3.24 (VREF), U4.24 (VREF); also elsewhere on the board
+24V: C17.1, C21.2, C23.1, C27.2, C32.2, C33.2, Q4.5 (D_1), Q4.6 (D_2), Q4.7 (D_3), Q4.8 (D_4), Q4.9 (D_5), Q4.10 (D_6), Q4.11 (D_7), Q7.5 (D_1), Q7.6 (D_2), Q7.7 (D_3), Q7.8 (D_4), Q7.9 (D_5), Q7.10 (D_6), Q7.11 (D_7), Q9.5 (D_1), Q9.6 (D_2), Q9.7 (D_3), Q9.8 (D_4), Q9.9 (D_5), Q9.10 (D_6), Q9.11 (D_7), Q11.5 (D_1), Q11.6 (D_2), Q11.7 (D_3), Q11.8 (D_4), Q11.9 (D_5), Q11.10 (D_6), Q11.11 (D_7), Q13.5 (D_1), Q13.6 (D_2), Q13.7 (D_3), Q13.8 (D_4), Q13.9 (D_5), Q13.10 (D_6), Q13.11 (D_7), Q15.5 (D_1), Q15.6 (D_2), Q15.7 (D_3), Q15.8 (D_4), Q15.9 (D_5), Q15.10 (D_6), Q15.11 (D_7), U3.3 (VM), U3.4 (VDRAIN), U4.3 (VM), U4.4 (VDRAIN); also elsewhere on the board
/ENABLE: U3.31 (ENABLE), U4.31 (ENABLE); also elsewhere on the board
/MOTOR2_DIR: U3.36 (INHC); also elsewhere on the board
/MOTOR2_PWM: U3.32 (INHA); also elsewhere on the board
/MOTOR3_DIR: U4.36 (INHC); also elsewhere on the board
/MOTOR3_PWM: U4.32 (INHA); also elsewhere on the board
/Motor_2/GAIN: R25.2, U3.30 (GAIN)
/Motor_2/GHA: Q7.4 (G), U3.6 (GHA)
/Motor_2/GHB: Q4.4 (G), U3.15 (GHB)
/Motor_2/GHC: Q11.4 (G), U3.16 (GHC)
/Motor_2/GLA: Q8.4 (G), U3.8 (GLA)
/Motor_2/GLB: Q20.4 (G), U3.13 (GLB)
/Motor_2/GLC: Q10.4 (G), U3.18 (GLC)
/Motor_2/HAL_1: U3.33 (INLA); also elsewhere on the board
/Motor_2/HAL_2: U3.34 (INHB); also elsewhere on the board
/Motor_2/HAL_3: U3.35 (INLB); also elsewhere on the board
/Motor_2/IDRIVE: R28.2, U3.28 (IDRIVE)
/Motor_2/MODE: R31.2, U3.27 (MODE)
/Motor_2/SHA: Q7.1 (S_1), Q7.2 (S_2), Q7.3 (S_3), Q8.5 (D_1), Q8.6 (D_2), Q8.7 (D_3), Q8.8 (D_4), Q8.9 (D_5), Q8.10 (D_6), Q8.11 (D_7), U3.7 (SHA); also elsewhere on the board
/Motor_2/SHB: Q4.1 (S_1), Q4.2 (S_2), Q4.3 (S_3), Q20.5 (D_1), Q20.6 (D_2), Q20.7 (D_3), Q20.8 (D_4), Q20.9 (D_5), Q20.10 (D_6), Q20.11 (D_7), U3.14 (SHB); also elsewhere on the board
/Motor_2/SHC: Q10.5 (D_1), Q10.6 (D_2), Q10.7 (D_3), Q10.8 (D_4), Q10.9 (D_5), Q10.10 (D_6), Q10.11 (D_7), Q11.1 (S_1), Q11.2 (S_2), Q11.3 (S_3), U3.17 (SHC); also elsewhere on the board
/Motor_2/SPA: Q8.1 (S_1), Q8.2 (S_2), Q8.3 (S_3), R10.2, U3.9 (SPA)
/Motor_2/SPB: Q20.1 (S_1), Q20.2 (S_2), Q20.3 (S_3), R16.2, U3.12 (SPB)
/Motor_2/SPC: Q10.1 (S_1), Q10.2 (S_2), Q10.3 (S_3), R13.2, U3.19 (SPC)
/Motor_2/VDS: R34.2, U3.29 (VDS)
/Motor_3/GAIN: R26.2, U4.30 (GAIN)
/Motor_3/GHA: Q13.4 (G), U4.6 (GHA)
/Motor_3/GHB: Q9.4 (G), U4.15 (GHB)
/Motor_3/GHC: Q15.4 (G), U4.16 (GHC)
/Motor_3/GLA: Q14.4 (G), U4.8 (GLA)
/Motor_3/GLB: Q21.4 (G), U4.13 (GLB)
/Motor_3/GLC: Q12.4 (G), U4.18 (GLC)
/Motor_3/HAL_1: U4.33 (INLA); also elsewhere on the board
/Motor_3/HAL_2: U4.34 (INHB); also elsewhere on the board
/Motor_3/HAL_3: U4.35 (INLB); also elsewhere on the board
/Motor_3/IDRIVE: R29.2, U4.28 (IDRIVE)
/Motor_3/MODE: R32.2, U4.27 (MODE)
/Motor_3/SHA: Q13.1 (S_1), Q13.2 (S_2), Q13.3 (S_3), Q14.5 (D_1), Q14.6 (D_2), Q14.7 (D_3), Q14.8 (D_4), Q14.9 (D_5), Q14.10 (D_6), Q14.11 (D_7), U4.7 (SHA); also elsewhere on the board
/Motor_3/SHB: Q9.1 (S_1), Q9.2 (S_2), Q9.3 (S_3), Q21.5 (D_1), Q21.6 (D_2), Q21.7 (D_3), Q21.8 (D_4), Q21.9 (D_5), Q21.10 (D_6), Q21.11 (D_7), U4.14 (SHB); also elsewhere on the board
/Motor_3/SHC: Q12.5 (D_1), Q12.6 (D_2), Q12.7 (D_3), Q12.8 (D_4), Q12.9 (D_5), Q12.10 (D_6), Q12.11 (D_7), Q15.1 (S_1), Q15.2 (S_2), Q15.3 (S_3), U4.17 (SHC); also elsewhere on the board
/Motor_3/SPA: Q14.1 (S_1), Q14.2 (S_2), Q14.3 (S_3), R11.2, U4.9 (SPA)
/Motor_3/SPB: Q21.1 (S_1), Q21.2 (S_2), Q21.3 (S_3), R17.2, U4.12 (SPB)
/Motor_3/SPC: Q12.1 (S_1), Q12.2 (S_2), Q12.3 (S_3), R14.2, U4.19 (SPC)
/Motor_3/VDS: R35.2, U4.29 (VDS)
/nBRAKE: U3.37 (INLC), U4.37 (INLC); also elsewhere on the board
GND: C17.2, C18.2, C19.2, C23.2, C24.2, C25.2, C29.1, C30.1, C32.1, C33.1, R10.1, R11.1, R13.1, R14.1, R16.1, R17.1, R25.1, R26.1, R28.1, R29.1, R31.1, R32.1, R34.1, R35.1, U3.10 (SNA), U3.11 (SNB), U3.20 (SNC), U3.25 (AGND), U3.39 (GND), U3.41 (EXP), U4.10 (SNA), U4.11 (SNB), U4.20 (SNC), U4.25 (AGND), U4.39 (GND), U4.41 (EXP); also elsewhere on the board
unnamed: D5.2 (A), R7.1
unnamed: D5.1 (K), U3.26 (~FAULT)
unnamed: D6.2 (A), R8.1
unnamed: D6.1 (K), U4.26 (~FAULT)
unnamed: C20.1, U3.2 (CPH)
unnamed: C20.2, U3.1 (CPL)
unnamed: C19.1, U3.38 (DVDD)
unnamed: C21.1, U3.5 (VCP)
unnamed: C29.2, U3.40 (VGLS)
unnamed: C26.1, U4.2 (CPH)
unnamed: C26.2, U4.1 (CPL)
unnamed: C25.1, U4.38 (DVDD)
unnamed: C27.1, U4.5 (VCP)
unnamed: C30.2, U4.40 (VGLS)

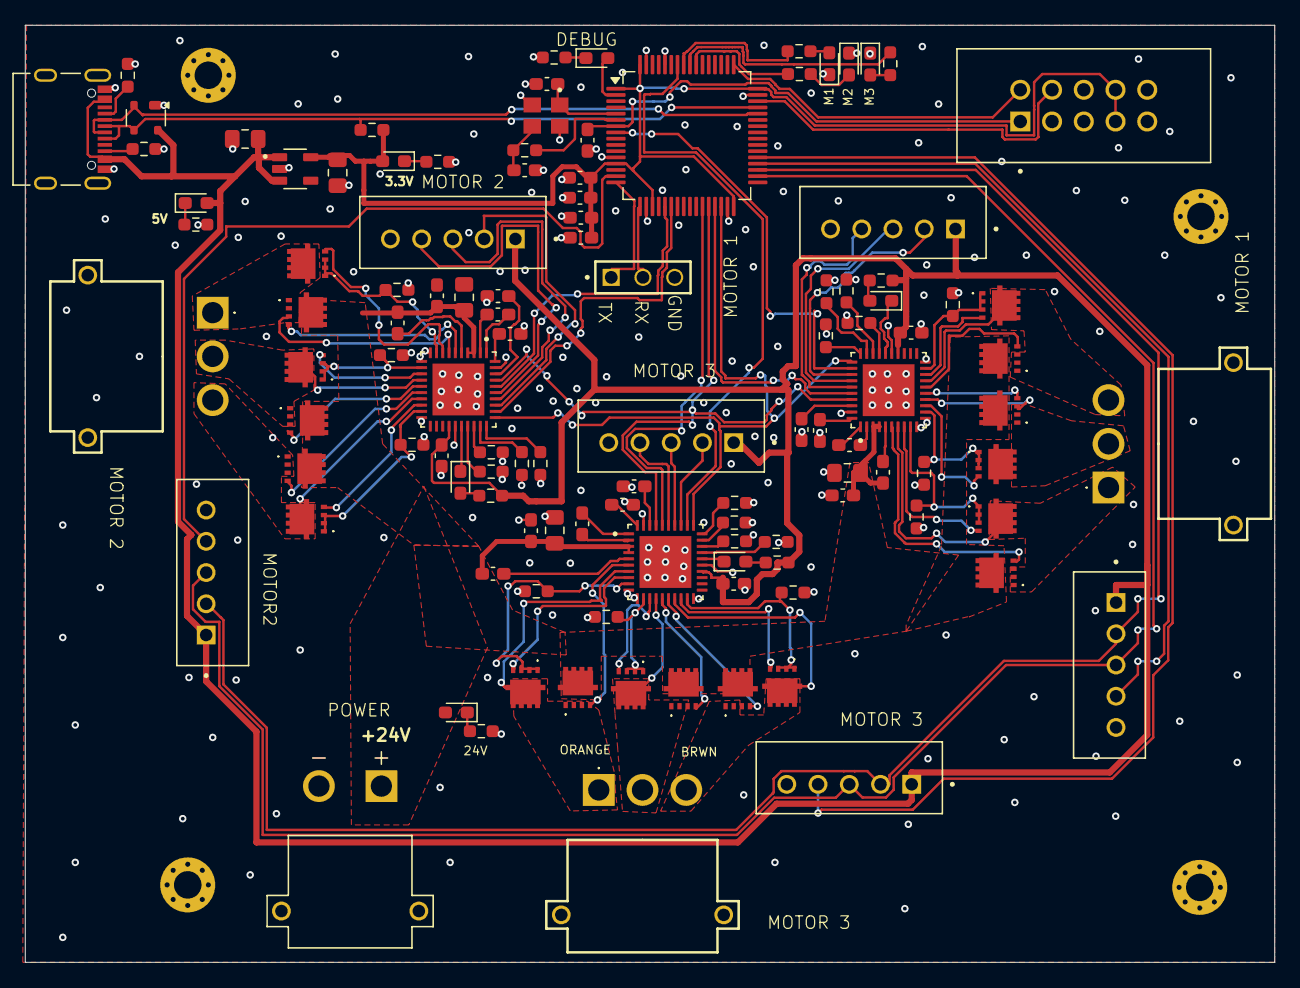
[picture p6: board SemuBot_WheelBase/hw_version/Wheelbase/Wheelbase.kicad_pcb from above]

Board: 2 copper layers, 100.0 x 75.0 mm, 117 parts (0 on the bottom side), 118 nets.
