SemuBot/SemuBot-PCB/(commit log)

2024-01-15 PCB and chematics initial
    [SemuBot-electronics-mainboard.kicad_pcb, SemuBot-electronics-mainboard.kicad_sch]
2024-11-29 Beginning of wheelbase pcb
    [Driver.kicad_sch, Wheelbase.kicad_pcb, Wheelbase.kicad_sch, untitled.kicad_sch]
2025-01-08 Revision time
    [Driver.kicad_sch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]
2025-01-28 Final version atm
    [Wheelbase-B_Cu.gbl, Wheelbase-B_Mask.gbs, Wheelbase-B_Paste.gbp, Wheelbase-B_Silkscreen.gbo, Wheelbase-Edge_Cuts.gm1, Wheelbase-F_Cu.gtl, Wheelbase-F_Mask.gts, Wheelbase-F_Paste.gtp]
2025-03-19 Updating board
    [Wheelbase.kicad_pcb, Wheelbase.kicad_sch, connectors.kicad_sch]
2025-04-15 Cable connection chart added
2025-04-22 Updated cable connection chart
2025-09-06 Random push
    [Driver.kicad_sch, Wheelbase.kicad_pcb, Wheelbase.kicad_sch, bom.csv, designators.csv, positions.csv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]
2025-11-24 Wheelbase HW version and SPI version.
    [Driver.kicad_sch, Wheelbase.kicad_pcb, Wheelbase.kicad_sch, bom.csv, connectors.kicad_sch, designators.csv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]
2025-11-25 SPI version
    [Wheelbase.kicad_pcb, Wheelbase.kicad_sch, connectors.kicad_sch]
2025-12-12 SPI version update
    [Wheelbase.kicad_pcb]
